freesoc/freesoc/README.md

freesoc
=======

freeSoC Board Layouts and Schematics
