freesoc/freesoc/freesoc mini/freesoc_mini_1.0.pdf

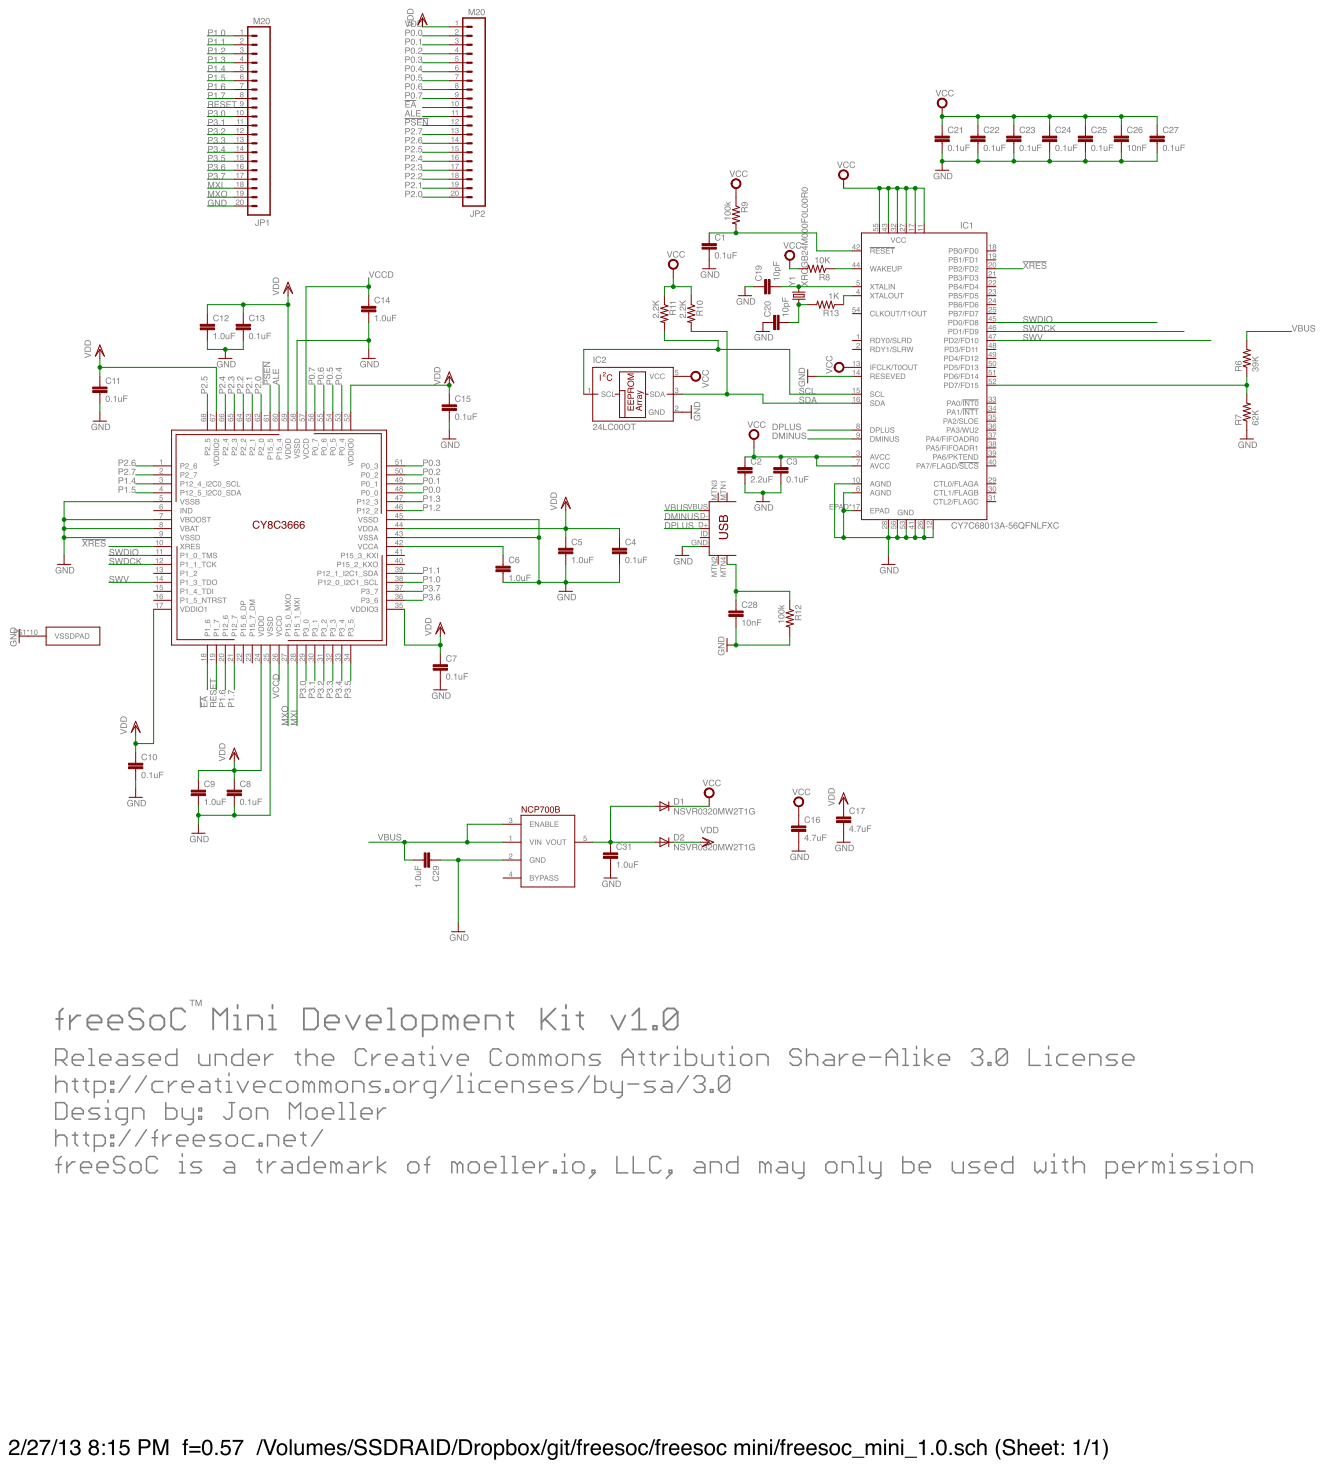
[picture p1: page 1]
