freesoc/freesoc/freesoc/freesoc_1.1.pdf

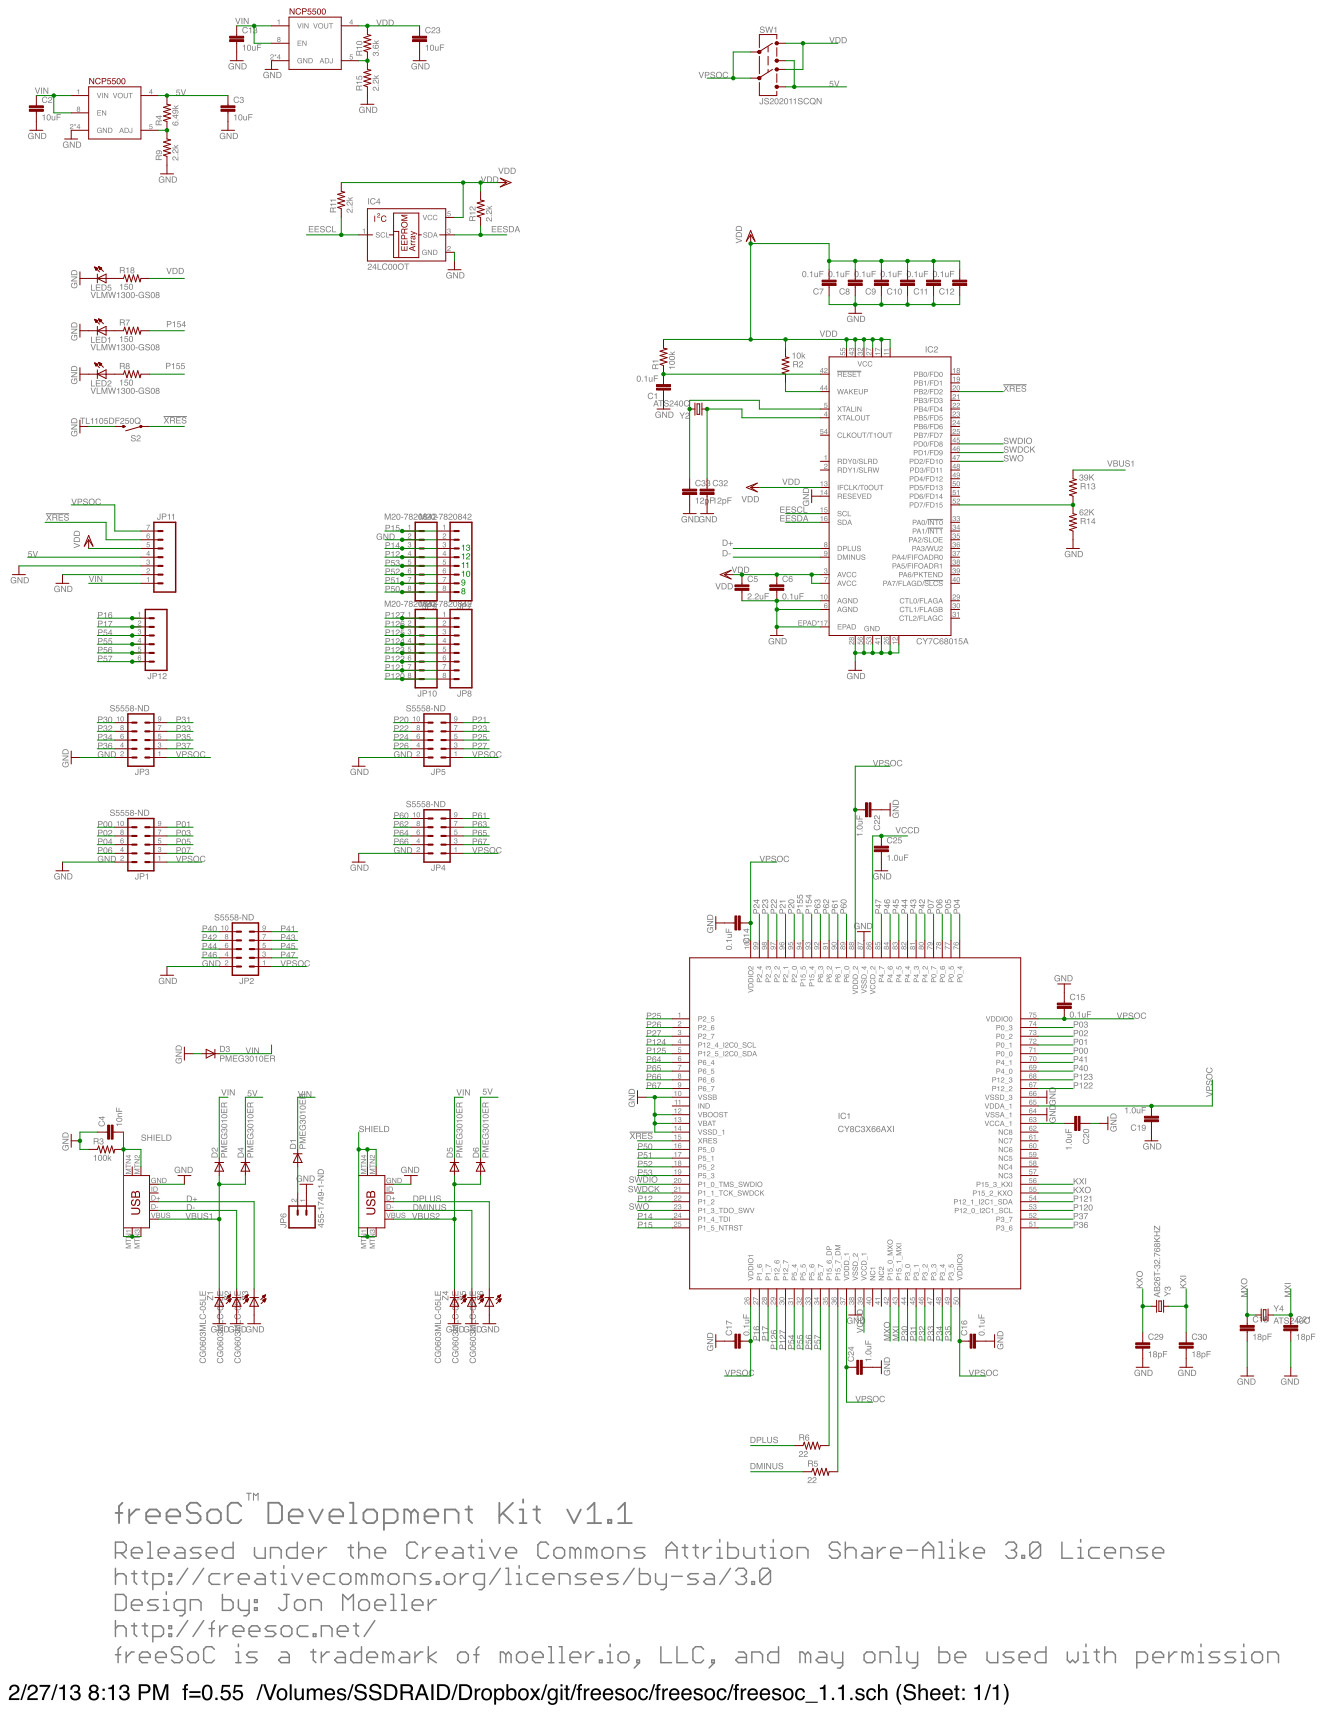
[picture p2: page 1]
