freesoc/freesoc/freesoc mini/freesoc_mini_1.0.brd

## EAGLE design freesoc mini/freesoc_mini_1.0.brd (2013-01-12)

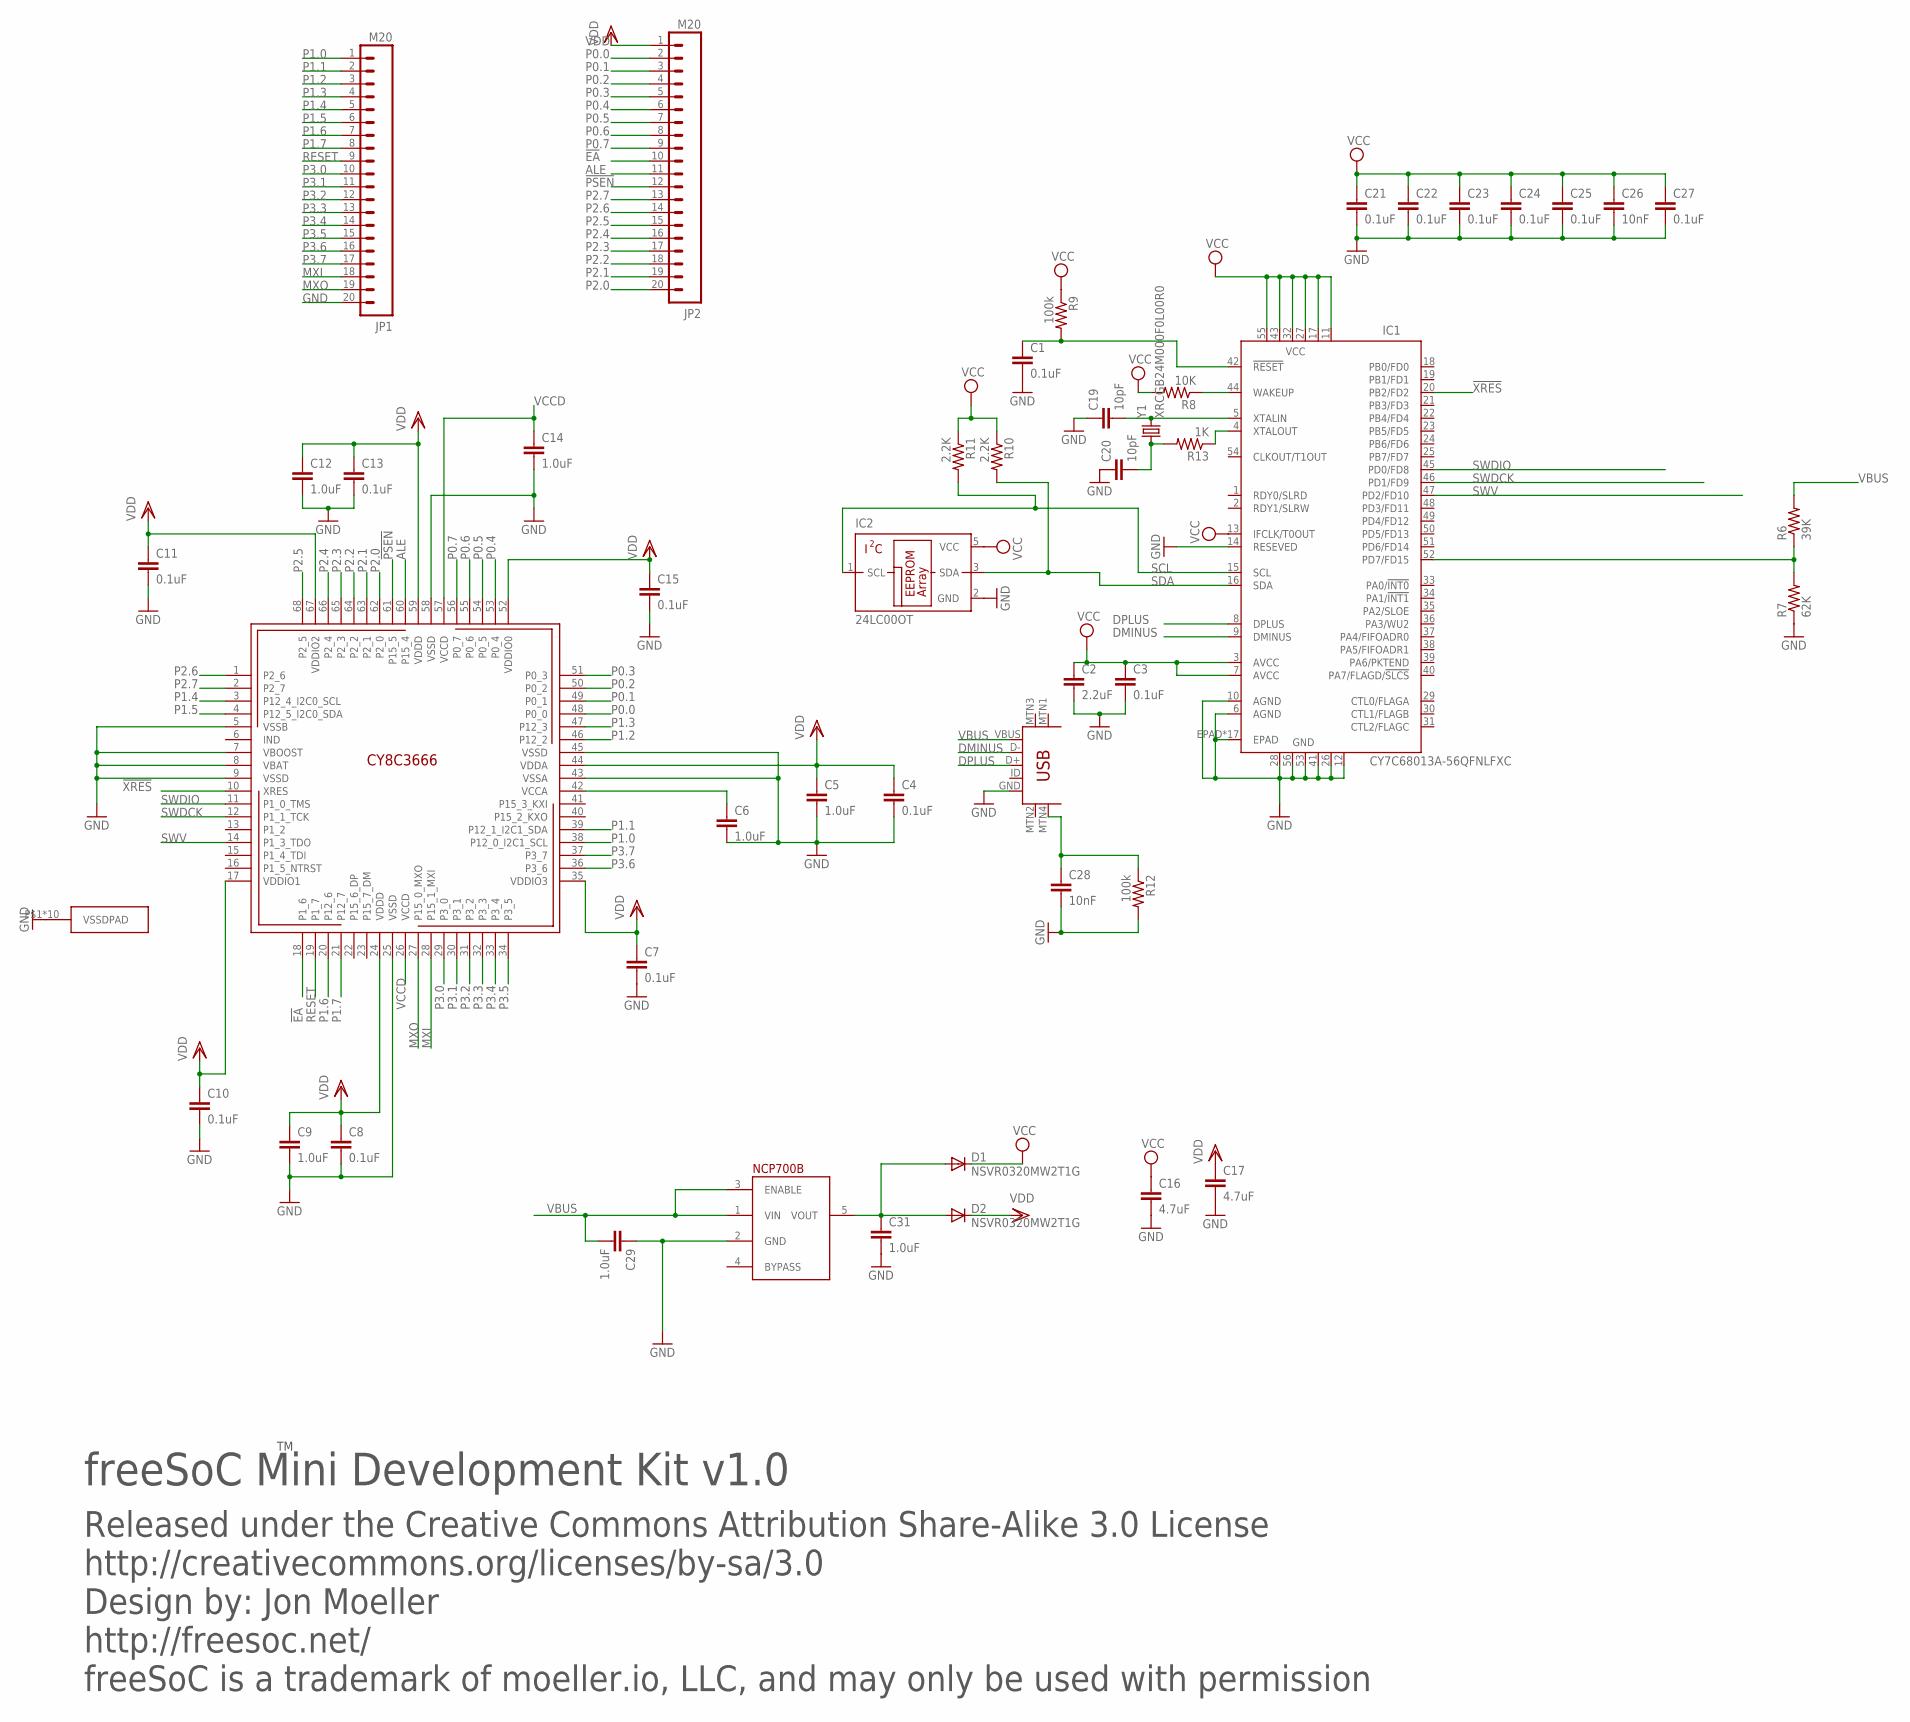
[picture p3: schematic freesoc_mini_1.0.sch]

Parts:
C1, C3, C4, C7, C8, C10, C11, C13, C15, C21, C22, C23, C24, C25, C27: 0.1uF; 0402-CAP
C2: 2.2uF; 0402-CAP
C5, C6, C9, C12, C14, C29, C31: 1.0uF; 0402-CAP
C16, C17: 4.7uF; 0603-CAP
C19, C20: 10pF; 0402-CAP
C26, C28: 10nF; 0402-CAP
D1, D2: NSVR0320MW2T1G; SOD-323
IC1: CY7C68013A-56QFNLFXC; QFN56
IC2: 24LC00OT; SOT23-5L
JP1, JP2: M20; 1X20
R6: 39K; 0402-RES
R7: 62K; 0402-RES
R8: 10K; 0402-RES
R9, R12: 100k; 0402-RES
R10, R11: 2.2K; 0402-RES
R13: 1K; 0402-RES
U$1: CY8C3X66LTI; QFN-68
U$3: FAN2558S36X; TSOP-5
USB-MINIB: USB-MINIB-5PIN; USB-MINIB
Y1: XRCGB24M000F0L00R0; CRYSTAL_RESONATOR

Connections:
!EA: JP2.10, U$1.18 (P1_6)
!PSEN: JP2.12, U$1.61 (P15_5)
!XRES: IC1.20 (PB2/FD2), U$1.10 (XRES)
ALE: JP2.11, U$1.60 (P15_4)
DMINUS: IC1.9 (DMINUS), USB-MINIB.D-
DPLUS: IC1.8 (DPLUS), USB-MINIB.D+
GND: C1.2, C2.2, C3.2, C4.2, C5.2, C6.2, C7.2, C8.2, C9.2, C10.2, C11.2, C12.2, C13.2, C14.2, C15.2, C16.2, C17.2, C19.1, C20.1, C21.2, C22.2, C23.2, C24.2, C25.2, C26.2, C27.2, C28.2, C29.1, C31.2, IC1.6 (AGND), IC1.10 (AGND), IC1.12 (GND), IC1.14 (RESEVED), IC1.26 (GND), IC1.28 (GND), IC1.41 (GND), IC1.53 (GND), IC1.56 (GND), IC1.EPAD, IC1.P$1 (EPAD), IC1.P$2 (EPAD), IC1.P$3 (EPAD), IC1.P$4 (EPAD), IC1.P$5 (EPAD), IC1.P$6 (EPAD), IC1.P$7 (EPAD), IC1.P$8 (EPAD), IC1.P$9 (EPAD), IC1.P$10 (EPAD), IC1.P$11 (EPAD), IC1.P$12 (EPAD), IC1.P$13 (EPAD), IC1.P$14 (EPAD), IC1.P$15 (EPAD), IC1.P$16 (EPAD), IC2.2 (GND), JP1.20, R7.1, R12.2, U$1.5 (VSSB), U$1.7 (VBOOST), U$1.8 (VBAT), U$1.9 (VSSD), U$1.25 (VSSD), U$1.43 (VSSA), U$1.45 (VSSD), U$1.58 (VSSD), U$1.P$1 (VSSDPAD), U$1.P$2 (VSSDPAD), U$1.P$3 (VSSDPAD), U$1.P$4 (VSSDPAD), U$1.P$5 (VSSDPAD), U$1.P$6 (VSSDPAD), U$1.P$7 (VSSDPAD), U$1.P$8 (VSSDPAD), U$1.P$9 (VSSDPAD), U$1.PAD (VSSDPAD), U$3.2 (GND), USB-MINIB.GND
MXI: JP1.18, U$1.28 (P15_1_MXI)
MXO: JP1.19, U$1.27 (P15_0_MXO)
unnamed: IC1.52 (PD7/FD15), R6.1, R7.2
unnamed: IC1.44 (WAKEUP), R8.1
unnamed: C1.1, IC1.42 (!RESET), R9.2
unnamed: C28.1, R12.1, USB-MINIB.MTN4
unnamed: IC1.4 (XTALOUT), R13.1
unnamed: C20.2, R13.2, Y1.P$1 (1)
unnamed: C19.2, IC1.5 (XTALIN), Y1.P$4 (2)
unnamed: C6.1, U$1.42 (VCCA)
P0.0: JP2.2, U$1.48 (P0_0)
P0.1: JP2.3, U$1.49 (P0_1)
P0.2: JP2.4, U$1.50 (P0_2)
P0.3: JP2.5, U$1.51 (P0_3)
P0.4: JP2.6, U$1.53 (P0_4)
P0.5: JP2.7, U$1.54 (P0_5)
P0.6: JP2.8, U$1.55 (P0_6)
P0.7: JP2.9, U$1.56 (P0_7)
P1.0: JP1.1, U$1.38 (P12_0_I2C1_SCL)
P1.1: JP1.2, U$1.39 (P12_1_I2C1_SDA)
P1.2: JP1.3, U$1.46 (P12_2)
P1.3: JP1.4, U$1.47 (P12_3)
P1.4: JP1.5, U$1.3 (P12_4_I2C0_SCL)
P1.5: JP1.6, U$1.4 (P12_5_I2C0_SDA)
P1.6: JP1.7, U$1.20 (P12_6)
P1.7: JP1.8, U$1.21 (P12_7)
P2.0: JP2.20, U$1.62 (P2_0)
P2.1: JP2.19, U$1.63 (P2_1)
P2.2: JP2.18, U$1.64 (P2_2)
P2.3: JP2.17, U$1.65 (P2_3)
P2.4: JP2.16, U$1.66 (P2_4)
P2.5: JP2.15, U$1.68 (P2_5)
P2.6: JP2.14, U$1.1 (P2_6)
P2.7: JP2.13, U$1.2 (P2_7)
P3.0: JP1.10, U$1.29 (P3_0)
P3.1: JP1.11, U$1.30 (P3_1)
P3.2: JP1.12, U$1.31 (P3_2)
P3.3: JP1.13, U$1.32 (P3_3)
P3.4: JP1.14, U$1.33 (P3_4)
P3.5: JP1.15, U$1.34 (P3_5)
P3.6: JP1.16, U$1.36 (P3_6)
P3.7: JP1.17, U$1.37 (P3_7)
RESET: JP1.9, U$1.19 (P1_7)
SCL: IC1.15 (SCL), IC2.1 (SCL), R11.2
SDA: IC1.16 (SDA), IC2.3 (SDA), R10.2
SWDCK: IC1.46 (PD1/FD9), U$1.12 (P1_1_TCK)
SWDIO: IC1.45 (PD0/FD8), U$1.11 (P1_0_TMS)
SWV: IC1.47 (PD2/FD10), U$1.14 (P1_3_TDO)
VBUS: C29.2, R6.2, U$3.1 (VIN), U$3.3 (ENABLE), USB-MINIB.VBUS
VCC: C2.1, C3.1, C16.1, C21.1, C22.1, C23.1, C24.1, C25.1, C26.1, C27.1, D1.1 (C), IC1.3 (AVCC), IC1.7 (AVCC), IC1.11 (VCC), IC1.13 (IFCLK/T0OUT), IC1.17 (VCC), IC1.27 (VCC), IC1.32 (VCC), IC1.43 (VCC), IC1.55 (VCC), IC2.5 (VCC), R8.2, R9.1, R10.1, R11.1
VCCD: C14.1, U$1.26 (VCCD), U$1.57 (VCCD)
VDD: C4.1, C5.1, C7.1, C8.1, C9.1, C10.1, C11.1, C12.1, C13.1, C15.1, C17.1, D2.1 (C), JP2.1, U$1.17 (VDDIO1), U$1.24 (VDDD), U$1.35 (VDDIO3), U$1.44 (VDDA), U$1.52 (VDDIO0), U$1.59 (VDDD), U$1.67 (VDDIO2)
VOUT: C31.1, D1.2 (A), D2.2 (A), U$3.5 (VOUT)

Notes on the sheet:
Released under the Creative Commons Attribution Share-Alike 3.0 License
http://creativecommons.org/licenses/by-sa/3.0
Design by: Jon Moeller
http://freesoc.net/
freeSoC is a trademark of moeller.io, LLC, and may only be used with permission
freeSoC Mini Development Kit v1.0

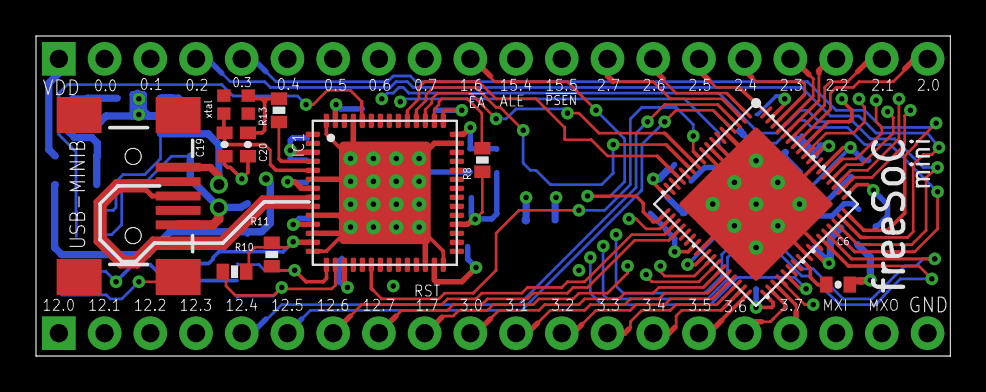
[picture p4: board freesoc_mini_1.0.brd from above]

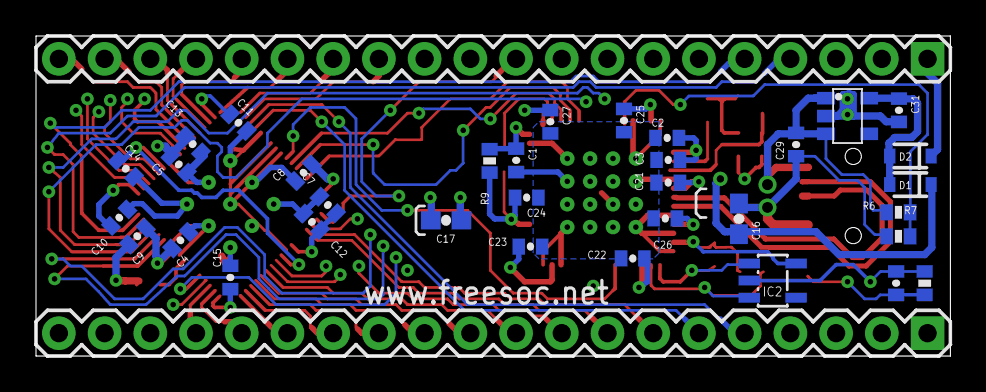
[picture p5: board freesoc_mini_1.0.brd from below]

Board: 4 copper layers, 50.8 x 17.8 mm, 47 parts (36 on the bottom side), 60 nets.
