freesoc/freesoc/freesoc/freesoc_1.0.brd

## EAGLE design freesoc/freesoc_1.0.brd (2013-01-12)

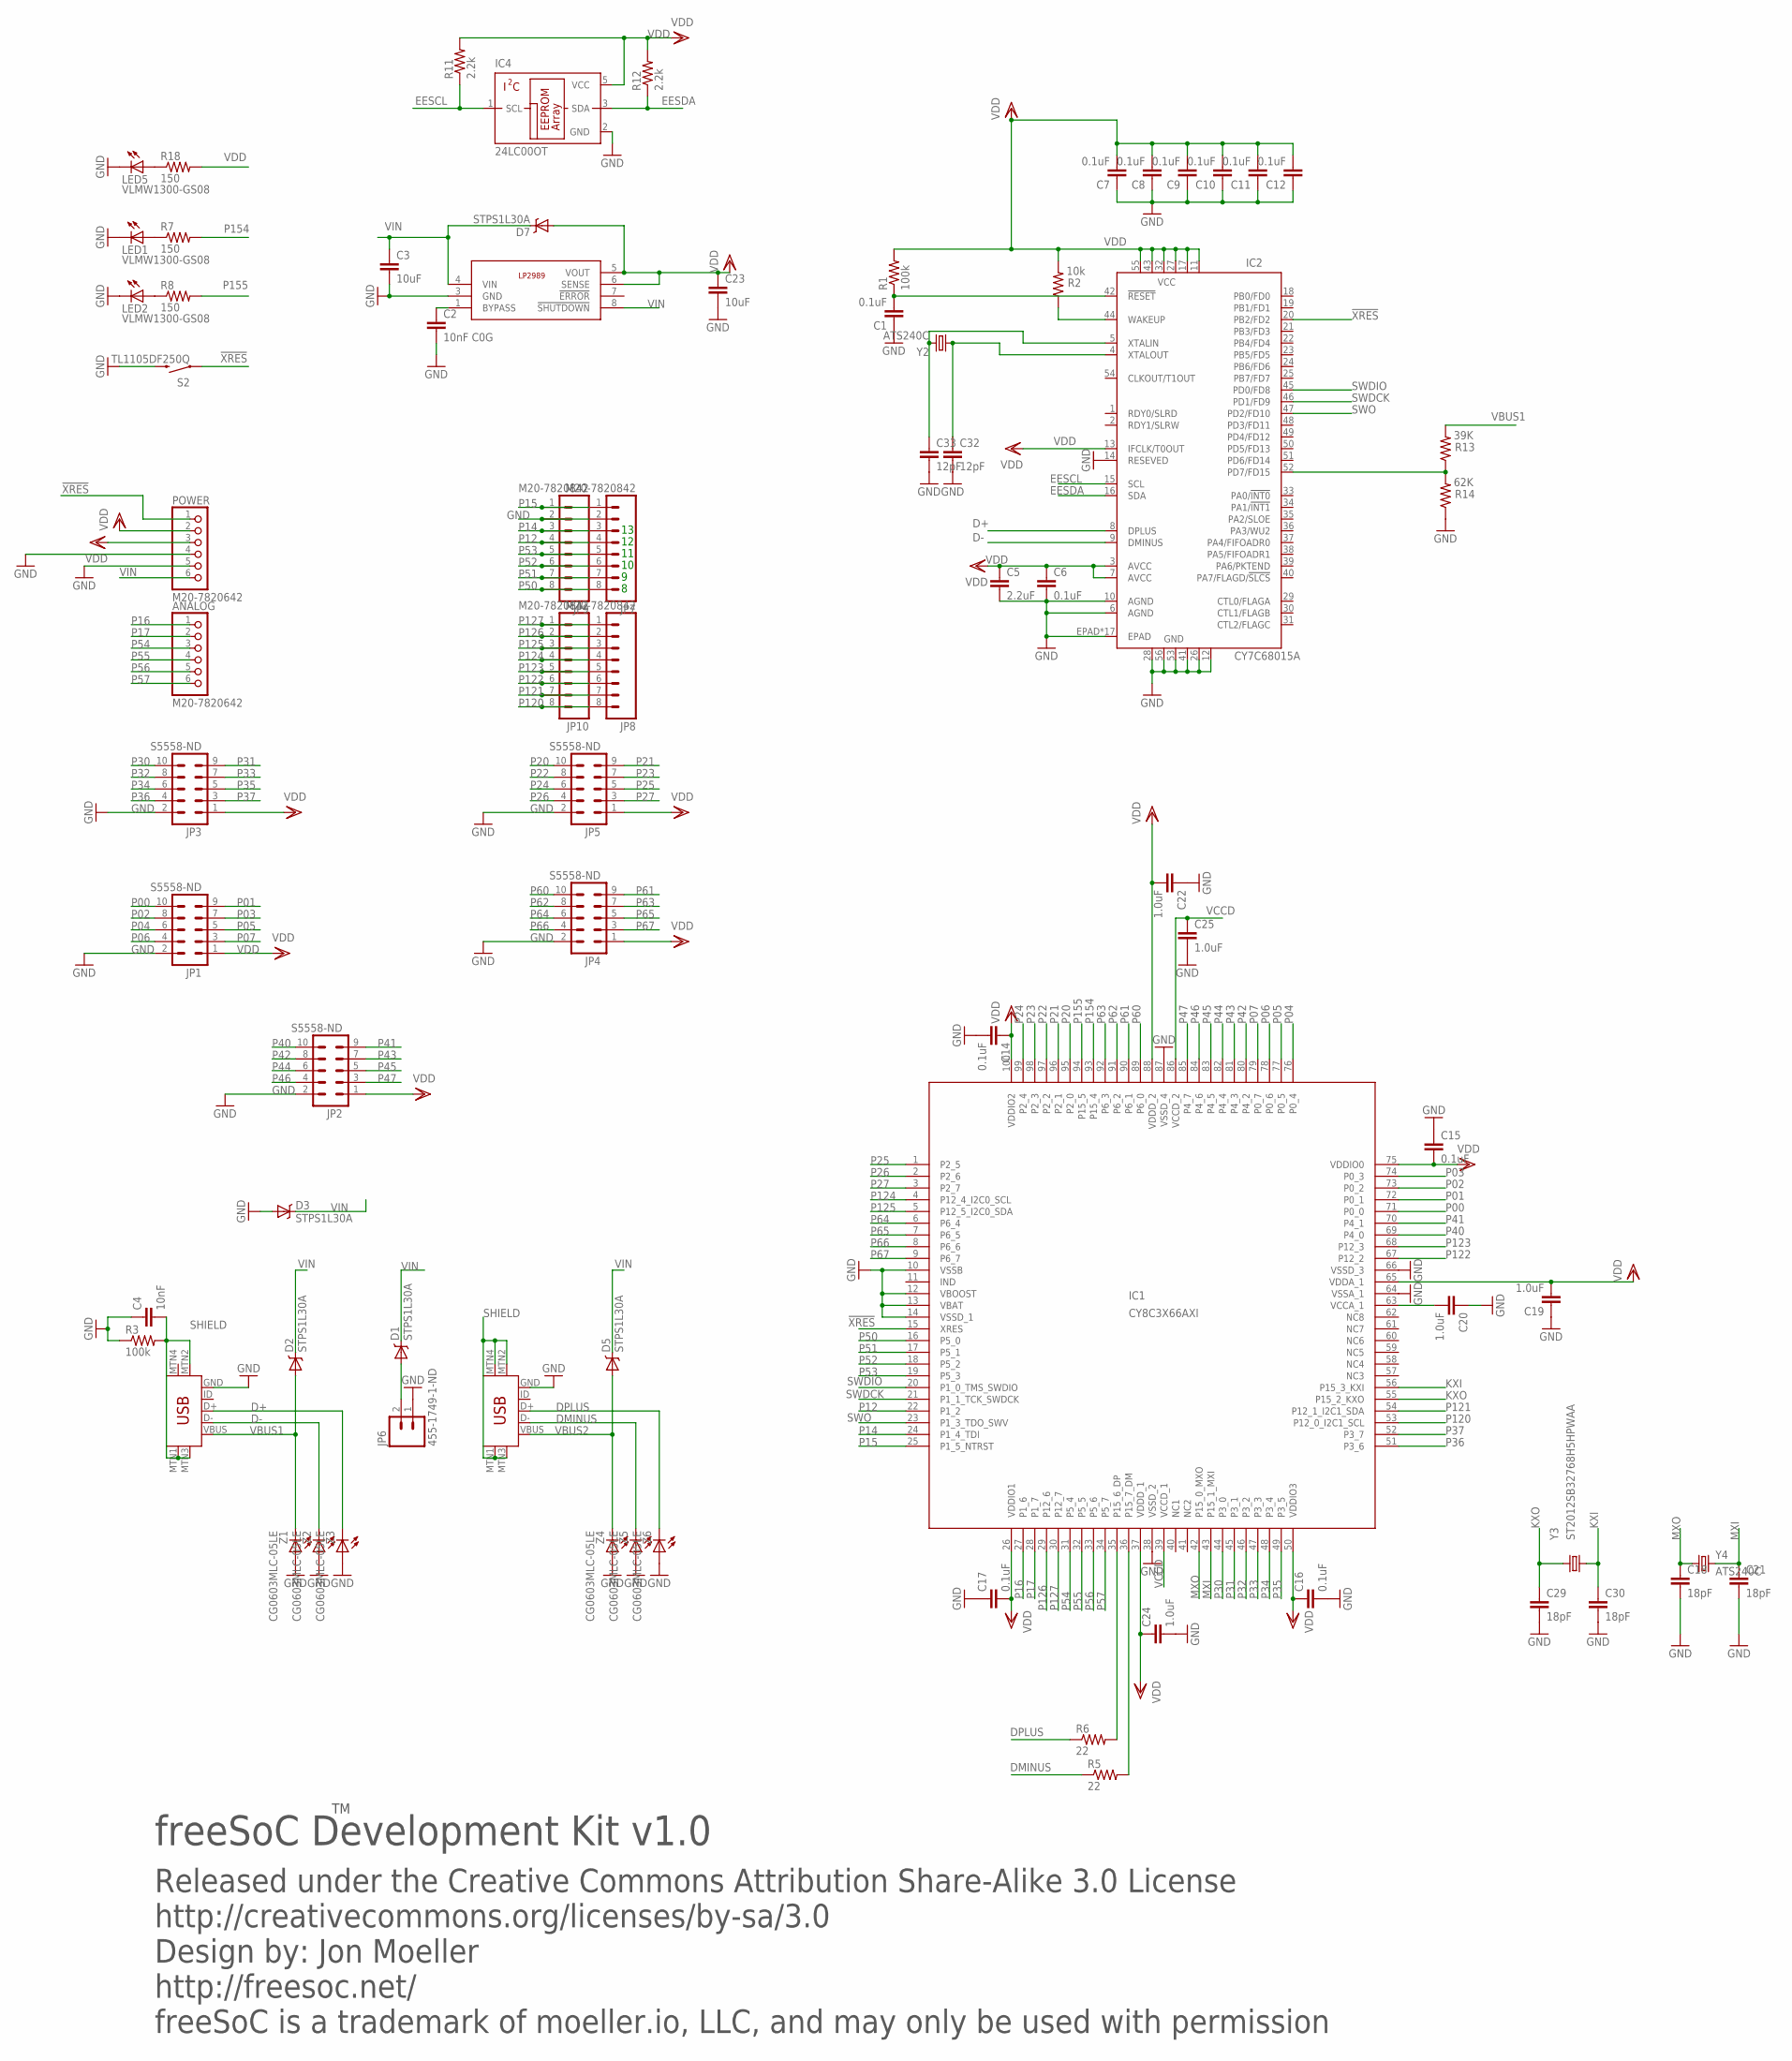
[picture p6: schematic freesoc_1.0.sch]

Parts:
ANALOG: M20-7820642; 1X06
C1, C6, C7, C8, C9, C10, C11, C12, C14, C15, C16, C17: 0.1uF; 0402-CAP
C2: 10nF C0G; 0402-CAP
C3, C23: 10uF; 1206
C4: 10nF; 0402-CAP
C5: 2.2uF; 0603-CAP
C18, C21, C29, C30: 18pF; 0402-CAP
C19, C20, C22, C24, C25: 1.0uF; 0402-CAP
C32, C33: 12pF; 0402-CAP
D1, D2, D3, D5, D7: STPS1L30A; SMA-DIODE
IC1: CY8C3X66AXI; TQFP-100
IC2: CY7C68015A; QFN56
IC4: 24LC00OT; SOT23-5L
JP1, JP2, JP3, JP4, JP5: S5558-ND; 2X5-RAF
JP6: 455-1749-1-ND; JST-2-SMD
JP7, JP8, JP9, JP10: M20-7820842; 1X08
LED1, LED2, LED5: VLMW1300-GS08; LED-0603
POWER: M20-7820642; 1X06
R1, R3: 100k; 0402-RES
R2: 10k; 0402-RES
R5, R6: 22; 0805
R7, R8, R18: 150; 0603-RES
R11, R12: 2.2k; 0402-RES
R13: 39K; 0402-RES
R14: 62K; 0402-RES
S2: TL1105DF250Q; TACTILE-PTH
U$1: LP2989; SO08
U$5, U$6: USB-MINIB-5PIN; USB-MINIB
Y2, Y4: ATS240C; HC49US
Y3: ST2012SB32768H5HPWAA; ST2012B
Z1, Z2, Z3, Z4, Z5, Z6: CG0603MLC-05LE; LED-0603

Connections:
!XRES: IC1.15 (XRES), IC2.20 (PB2/FD2), POWER.1, S2.1
D+: IC2.8 (DPLUS), U$5.D+, Z3.C
D-: IC2.9 (DMINUS), U$5.D-, Z2.C
DMINUS: R5.1, U$6.D-, Z5.C
DPLUS: R6.1, U$6.D+, Z6.C
EESCL: IC2.15 (SCL), IC4.1 (SCL), R11.1
EESDA: IC2.16 (SDA), IC4.3 (SDA), R12.1
GND: C1.1, C2.2, C3.2, C4.1, C5.2, C6.2, C7.1, C8.1, C9.1, C10.1, C11.1, C12.1, C14.2, C15.1, C16.2, C17.1, C18.2, C19.1, C20.1, C21.2, C22.1, C23.2, C24.2, C25.2, C29.2, C30.2, C32.2, C33.2, D3.A, IC1.10 (VSSB), IC1.12 (VBOOST), IC1.13 (VBAT), IC1.14 (VSSD_1), IC1.38 (VSSD_2), IC1.64 (VSSA_1), IC1.66 (VSSD_3), IC1.87 (VSSD_4), IC2.6 (AGND), IC2.10 (AGND), IC2.12 (GND), IC2.14 (RESEVED), IC2.26 (GND), IC2.28 (GND), IC2.41 (GND), IC2.53 (GND), IC2.56 (GND), IC2.EPAD, IC2.P$1 (EPAD), IC2.P$2 (EPAD), IC2.P$3 (EPAD), IC2.P$4 (EPAD), IC2.P$5 (EPAD), IC2.P$6 (EPAD), IC2.P$7 (EPAD), IC2.P$8 (EPAD), IC2.P$9 (EPAD), IC2.P$10 (EPAD), IC2.P$11 (EPAD), IC2.P$12 (EPAD), IC2.P$13 (EPAD), IC2.P$14 (EPAD), IC2.P$15 (EPAD), IC2.P$16 (EPAD), IC4.2 (GND), JP1.2, JP2.2, JP3.2, JP4.2, JP5.2, JP6.1, JP7.2, JP9.2, LED1.C, LED2.C, LED5.C, POWER.4, POWER.5, R3.1, R14.1, S2.3 (2), U$1.3 (GND), U$5.GND, U$6.GND, Z1.A, Z2.A, Z3.A, Z4.A, Z5.A, Z6.A
KXI: C30.1, IC1.56 (P15_3_KXI), Y3.P$2 (2)
KXO: C29.1, IC1.55 (P15_2_KXO), Y3.P$1 (1)
MXI: C21.1, IC1.43 (P15_1_MXI), Y4.2
MXO: C18.1, IC1.42 (P15_0_MXO), Y4.1
unnamed: C1.2, IC2.42 (!RESET), R1.1
unnamed: D1.A, JP6.2
unnamed: IC2.44 (WAKEUP), R2.1
unnamed: C20.2, IC1.63 (VCCA_1)
unnamed: IC1.35 (P15_6_DP), R6.2
unnamed: IC1.36 (P15_7_DM), R5.2
unnamed: LED1.A, R7.1
unnamed: LED2.A, R8.1
unnamed: C2.1, U$1.1 (BYPASS)
unnamed: IC2.52 (PD7/FD15), R13.1, R14.2
unnamed: LED5.A, R18.1
P00: IC1.71 (P0_0), JP1.10
P01: IC1.72 (P0_1), JP1.9
P02: IC1.73 (P0_2), JP1.8
P03: IC1.74 (P0_3), JP1.7
P04: IC1.76 (P0_4), JP1.6
P05: IC1.77 (P0_5), JP1.5
P06: IC1.78 (P0_6), JP1.4
P07: IC1.79 (P0_7), JP1.3
P12: IC1.22 (P1_2), JP7.4, JP9.4
P14: IC1.24 (P1_4_TDI), JP7.3, JP9.3
P15: IC1.25 (P1_5_NTRST), JP7.1, JP9.1
P16: ANALOG.1, IC1.27 (P1_6)
P17: ANALOG.2, IC1.28 (P1_7)
P20: IC1.95 (P2_0), JP5.10
P21: IC1.96 (P2_1), JP5.9
P22: IC1.97 (P2_2), JP5.8
P23: IC1.98 (P2_3), JP5.7
P24: IC1.99 (P2_4), JP5.6
P25: IC1.1 (P2_5), JP5.5
P26: IC1.2 (P2_6), JP5.4
P27: IC1.3 (P2_7), JP5.3
P30: IC1.44 (P3_0), JP3.10
P31: IC1.45 (P3_1), JP3.9
P32: IC1.46 (P3_2), JP3.8
P33: IC1.47 (P3_3), JP3.7
P34: IC1.48 (P3_4), JP3.6
P35: IC1.49 (P3_5), JP3.5
P36: IC1.51 (P3_6), JP3.4
P37: IC1.52 (P3_7), JP3.3
P40: IC1.69 (P4_0), JP2.10
P41: IC1.70 (P4_1), JP2.9
P42: IC1.80 (P4_2), JP2.8
P43: IC1.81 (P4_3), JP2.7
P44: IC1.82 (P4_4), JP2.6
P45: IC1.83 (P4_5), JP2.5
P46: IC1.84 (P4_6), JP2.4
P47: IC1.85 (P4_7), JP2.3
P50: IC1.16 (P5_0), JP7.8, JP9.8
P51: IC1.17 (P5_1), JP7.7, JP9.7
P52: IC1.18 (P5_2), JP7.6, JP9.6
P53: IC1.19 (P5_3), JP7.5, JP9.5
P54: ANALOG.3, IC1.31 (P5_4)
P55: ANALOG.4, IC1.32 (P5_5)
P56: ANALOG.5, IC1.33 (P5_6)
P57: ANALOG.6, IC1.34 (P5_7)
P60: IC1.89 (P6_0), JP4.10
P61: IC1.90 (P6_1), JP4.9
P62: IC1.91 (P6_2), JP4.8
P63: IC1.92 (P6_3), JP4.7
P64: IC1.6 (P6_4), JP4.6
P65: IC1.7 (P6_5), JP4.5
P66: IC1.8 (P6_6), JP4.4
P67: IC1.9 (P6_7), JP4.3
P120: IC1.53 (P12_0_I2C1_SCL), JP8.8, JP10.8
P121: IC1.54 (P12_1_I2C1_SDA), JP8.7, JP10.7
P122: IC1.67 (P12_2), JP8.6, JP10.6
P123: IC1.68 (P12_3), JP8.5, JP10.5
P124: IC1.4 (P12_4_I2C0_SCL), JP8.4, JP10.4
P125: IC1.5 (P12_5_I2C0_SDA), JP8.3, JP10.3
P126: IC1.29 (P12_6), JP8.2, JP10.2
P127: IC1.30 (P12_7), JP8.1, JP10.1
P154: IC1.93 (P15_4), R7.2
P155: IC1.94 (P15_5), R8.2
SHIELD: C4.2, R3.2, U$5.MTN1 (MTN2), U$5.MTN2 (MTN3), U$5.MTN3 (MTN1), U$6.MTN1 (MTN2), U$6.MTN2 (MTN3), U$6.MTN3 (MTN1), U$6.MTN4
SWDCK: IC1.21 (P1_1_TCK_SWDCK), IC2.46 (PD1/FD9)
SWDIO: IC1.20 (P1_0_TMS_SWDIO), IC2.45 (PD0/FD8)
SWO: IC1.23 (P1_3_TDO_SWV), IC2.47 (PD2/FD10)
VBUS1: D2.A, R13.2, U$5.VBUS, Z1.C
VBUS2: D5.A, U$6.VBUS, Z4.C
VCCD: C25.1, IC1.39 (VCCD_1), IC1.86 (VCCD_2)
VDD: C5.1, C6.1, C7.2, C8.2, C9.2, C10.2, C11.2, C12.2, C14.1, C15.2, C16.1, C17.2, C19.2, C22.2, C23.1, C24.1, D7.A, IC1.26 (VDDIO1), IC1.37 (VDDD_1), IC1.50 (VDDIO3), IC1.65 (VDDA_1), IC1.75 (VDDIO0), IC1.88 (VDDD_2), IC1.100 (VDDIO2), IC2.3 (AVCC), IC2.7 (AVCC), IC2.11 (VCC), IC2.13 (IFCLK/T0OUT), IC2.17 (VCC), IC2.27 (VCC), IC2.32 (VCC), IC2.43 (VCC), IC2.55 (VCC), IC4.5 (VCC), JP1.1, JP2.1, JP3.1, JP4.1, JP5.1, POWER.2, POWER.3, R1.2, R2.2, R11.2, R12.2, R18.2, U$1.5 (VOUT), U$1.6 (SENSE)
VIN: C3.1, D1.C, D2.C, D3.C, D5.C, D7.C, POWER.6, U$1.4 (VIN), U$1.8 (!SHUTDOWN)
XIN: C33.1, IC2.5 (XTALIN), Y2.2
XOUT: C32.1, IC2.4 (XTALOUT), Y2.1

Notes on the sheet:
Released under the Creative Commons Attribution Share-Alike 3.0 License
http://creativecommons.org/licenses/by-sa/3.0
Design by: Jon Moeller
http://freesoc.net/
freeSoC is a trademark of moeller.io, LLC, and may only be used with permission
freeSoC Development Kit v1.0

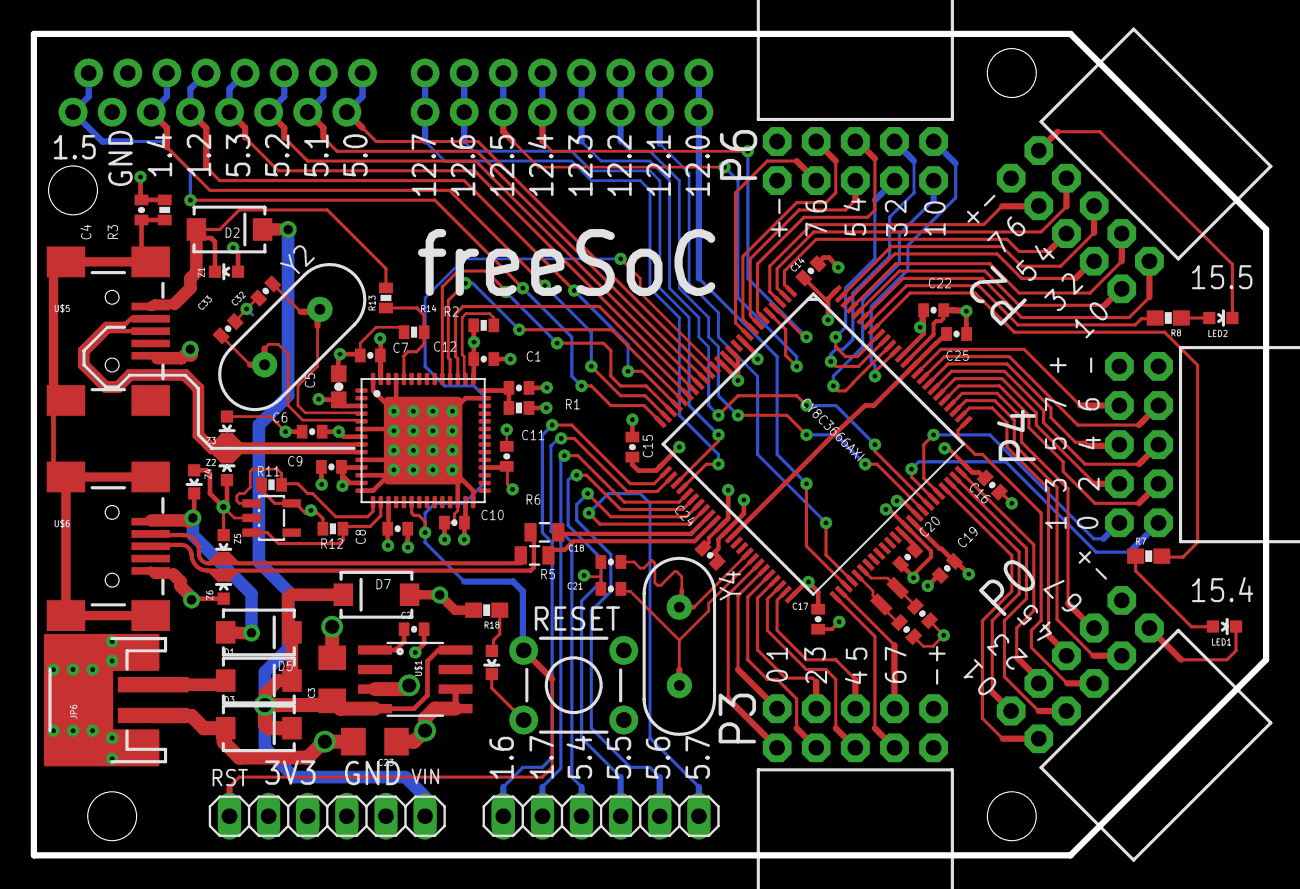
[picture p7: board freesoc_1.0.brd from above]

Board: 4 copper layers, 80.0 x 53.3 mm, 76 parts (0 on the bottom side), 97 nets.
