freesoc/freesoc/(commit log)

2012-09-07 Adding freeSoC and freeSoC Mini board designs and schematics
    Initial commit of board layouts and schematics
    [freesoc_1.0.brd, freesoc_1.0.sch, freesoc_mini_1.0.brd, freesoc_mini_1.0.sch]
2012-09-25 DFM changes to freeSoC
    Updated board for 7/7mil trace/space.
    All vias are now tented.
    Updated FX2 QFN pad land for improved reliability
    [freesoc_1.0.brd, freesoc_1.0.sch]
2012-09-25 DFM changes to freesoc mini board
    All vias tented.
    Updated land pattern for FX2 and PSoC for improved reliability and
    smaller defect rate.
    [freesoc_mini_1.0.brd, freesoc_mini_1.0.sch]
2012-09-25 More DFM changes
    Updated FX2 QFN package thermal pad dimensions to meet Cypress spec.
    Added tented vias on thermal pad, appropriate solder paste mask, and
    opened vias on bottom to eliminate outgassing
    [freesoc_1.0.brd, freesoc_1.0.sch]
2012-09-25 More DFM changes for freesoc mini
    Updated FX2 QFN thermal pad to meet cypress spec.
    Updated PSoC QFN thermal pad to meet cypress spec.
    Added tented vias on thermal pad for both chips, proper solder paste
    stencil, and removed solder mask from bottom of vias to prevent
    outgassing.
    [freesoc_mini_1.0.brd, freesoc_mini_1.0.sch]
2012-11-10 Changes for production
    [freesoc_1.1.brd, freesoc_1.1.sch, freesoc_mini_1.0.brd, freesoc_mini_1.0.sch]
2013-01-12 Updates to boards for production
    [freesoc_1.0.brd, freesoc_1.0.sch, freesoc_1.1.sch, freesoc_mini_1.0.brd, freesoc_mini_1.0.sch]
2013-02-28 Adding PDF Schematics
